STEP3DLab/table-motion-sensor/assets/battery.png

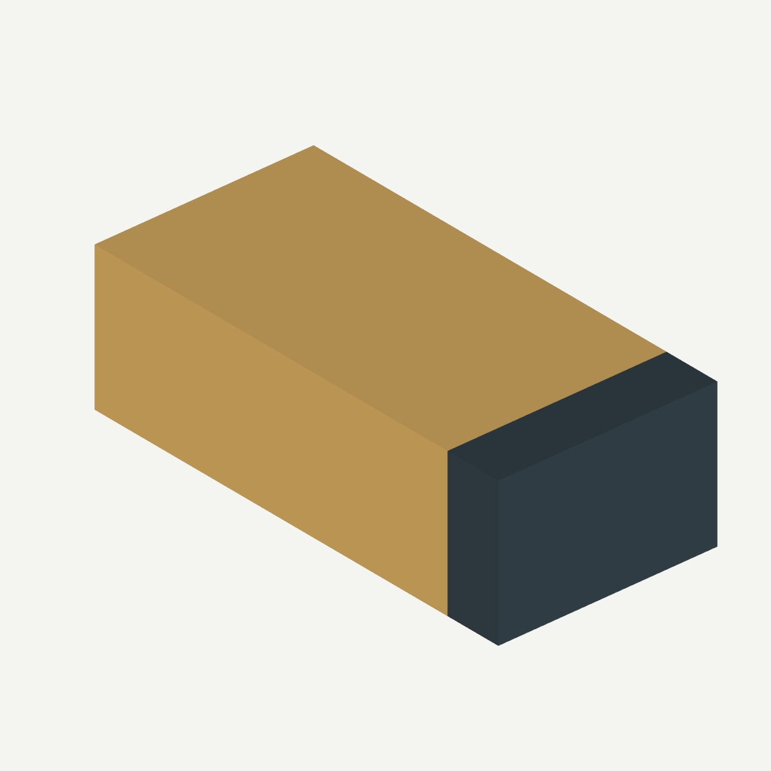
assets/battery.png
