STEP3DLab/table-motion-sensor/assets/case.png

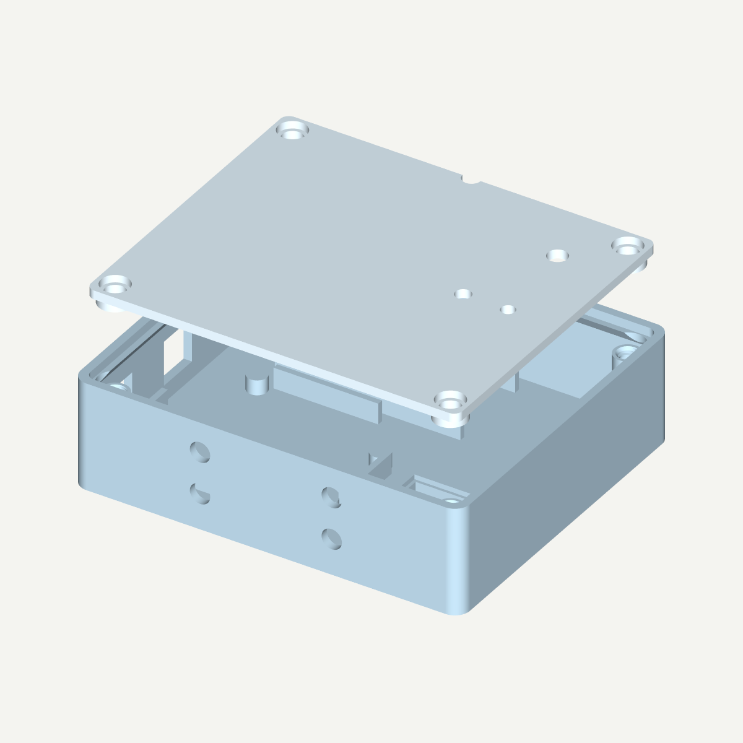
assets/case.png
