STEP3DLab/table-motion-sensor/assets/clamp.png

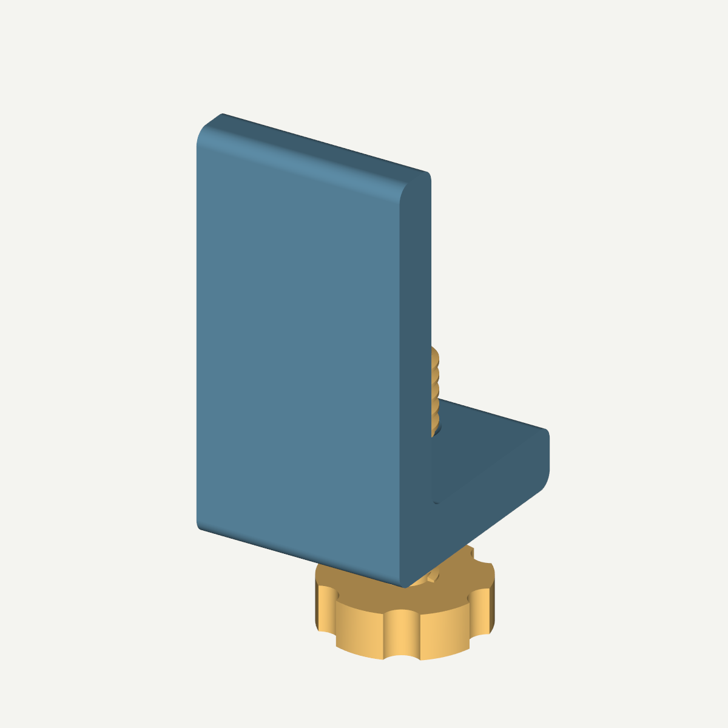
assets/clamp.png
