STEP3DLab/table-motion-sensor/assets/device.png

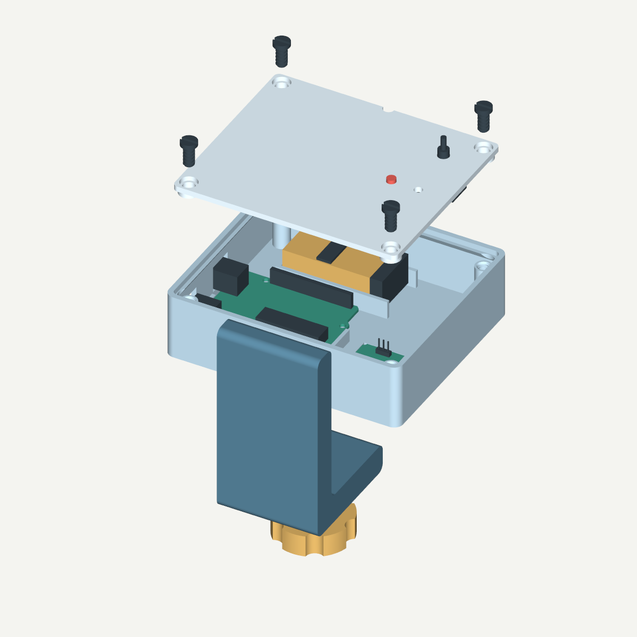
assets/device.png
