STEP3DLab/table-motion-sensor/assets/led.png

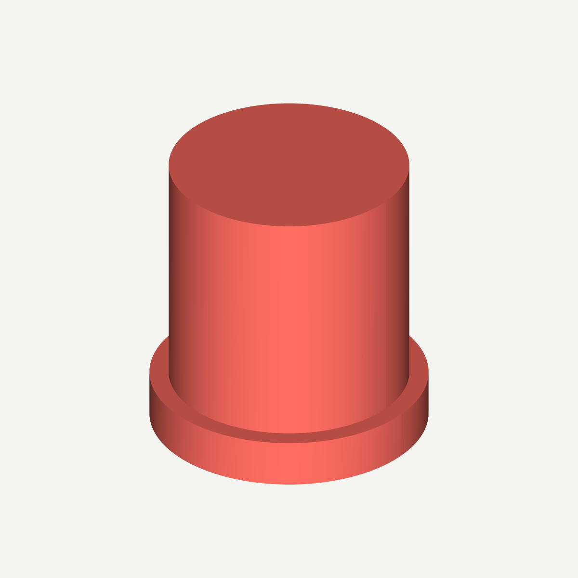
assets/led.png
