STEP3DLab/table-motion-sensor/assets/mount_01_uno.png

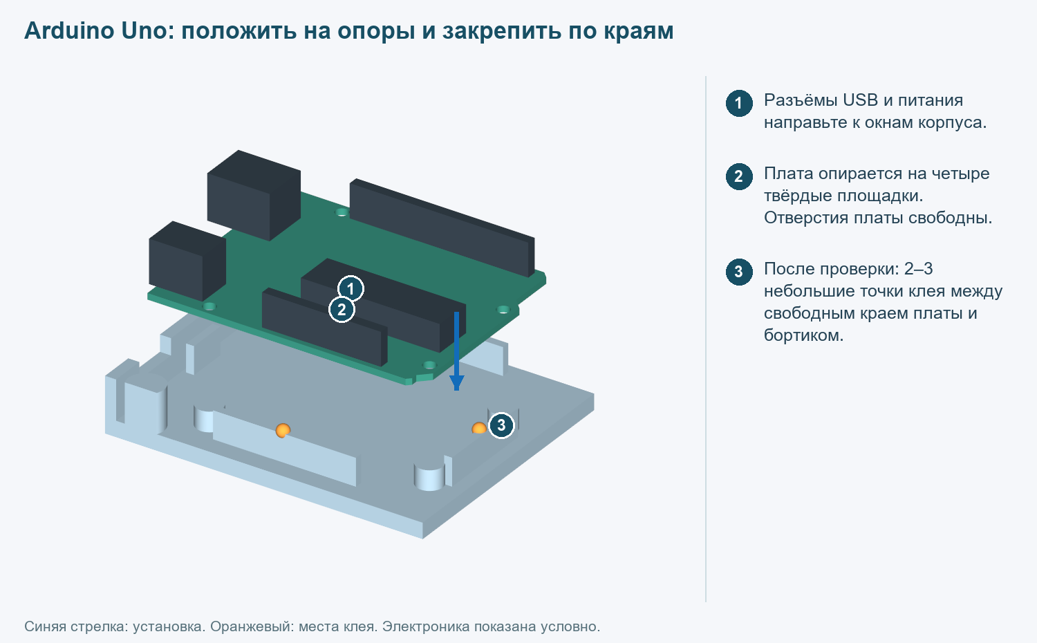
assets/mount_01_uno.png
