STEP3DLab/table-motion-sensor/assets/mount_02_sensor.png

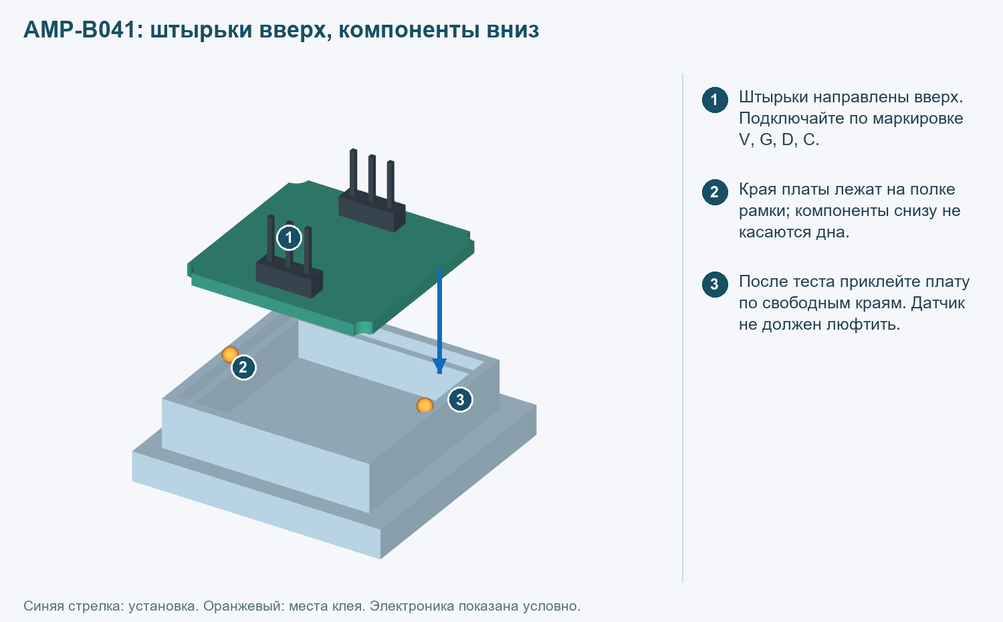
assets/mount_02_sensor.png
