STEP3DLab/table-motion-sensor/assets/mount_03_battery.png

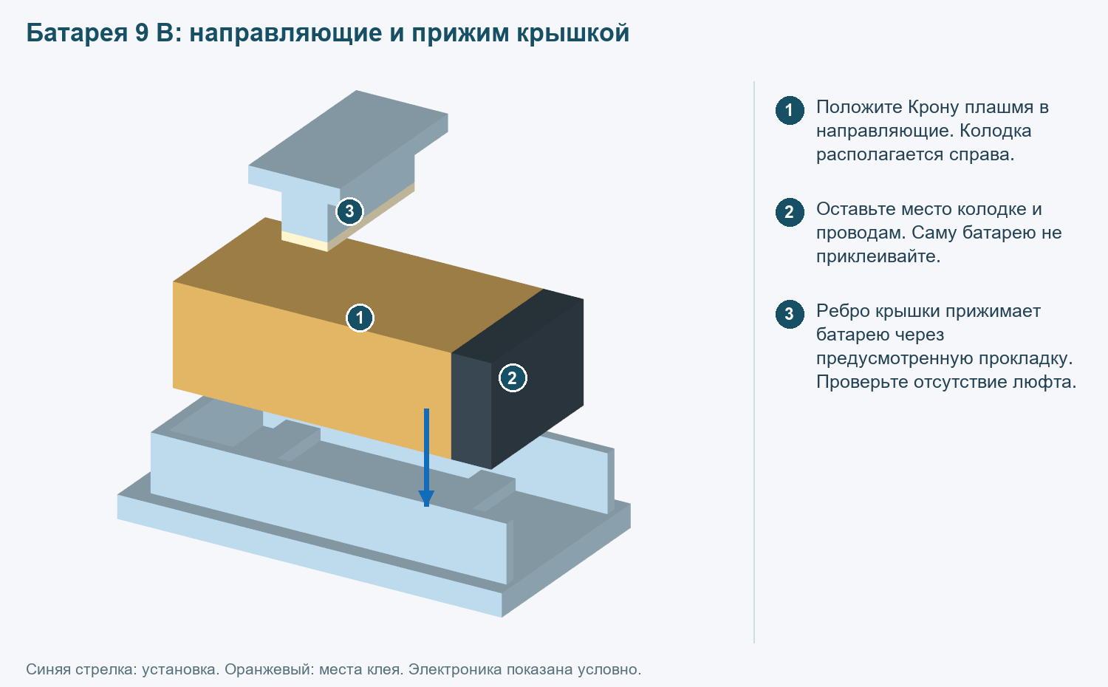
assets/mount_03_battery.png
