STEP3DLab/table-motion-sensor/assets/mount_04_led.png

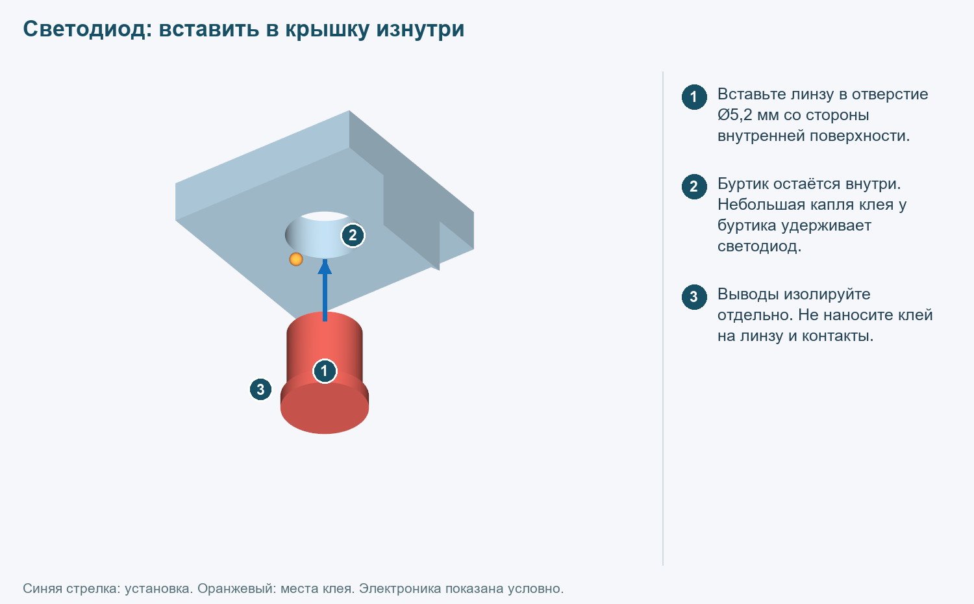
assets/mount_04_led.png
