STEP3DLab/table-motion-sensor/assets/mount_05_piezo.png

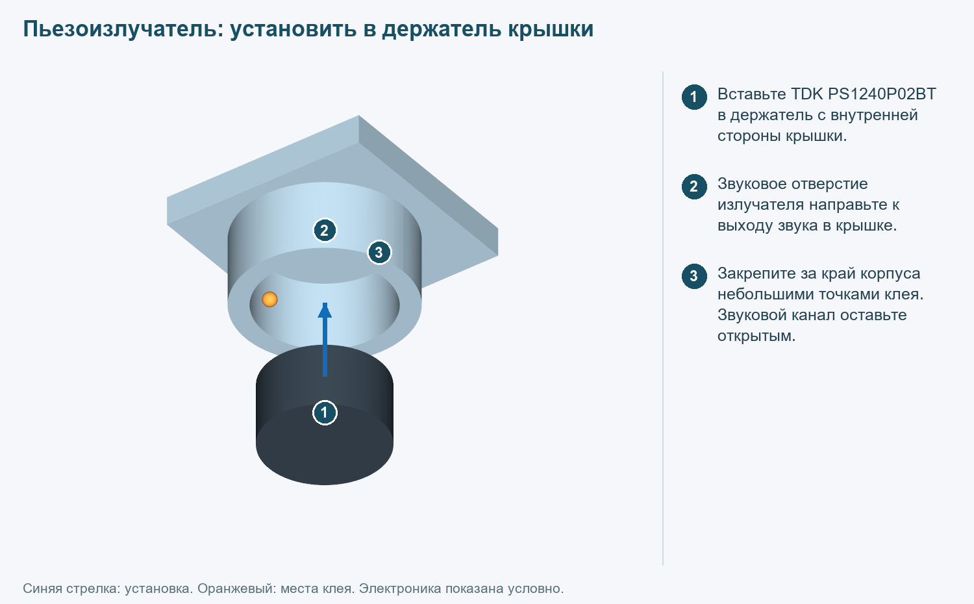
assets/mount_05_piezo.png
