STEP3DLab/table-motion-sensor/assets/mount_06_switch.png

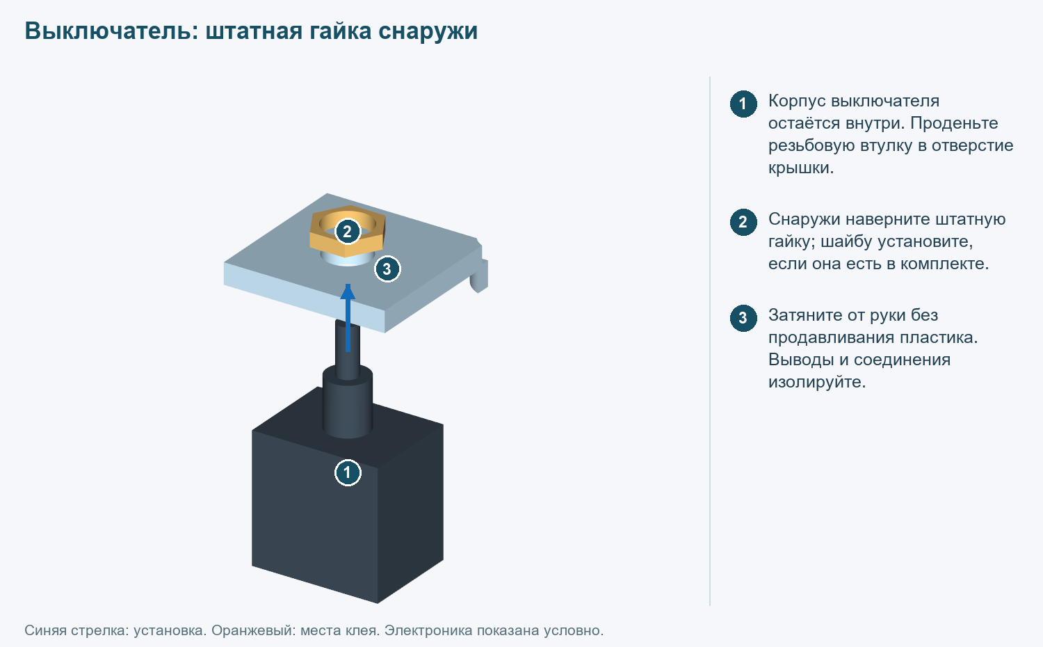
assets/mount_06_switch.png
