STEP3DLab/table-motion-sensor/assets/mount_07_clamp.png

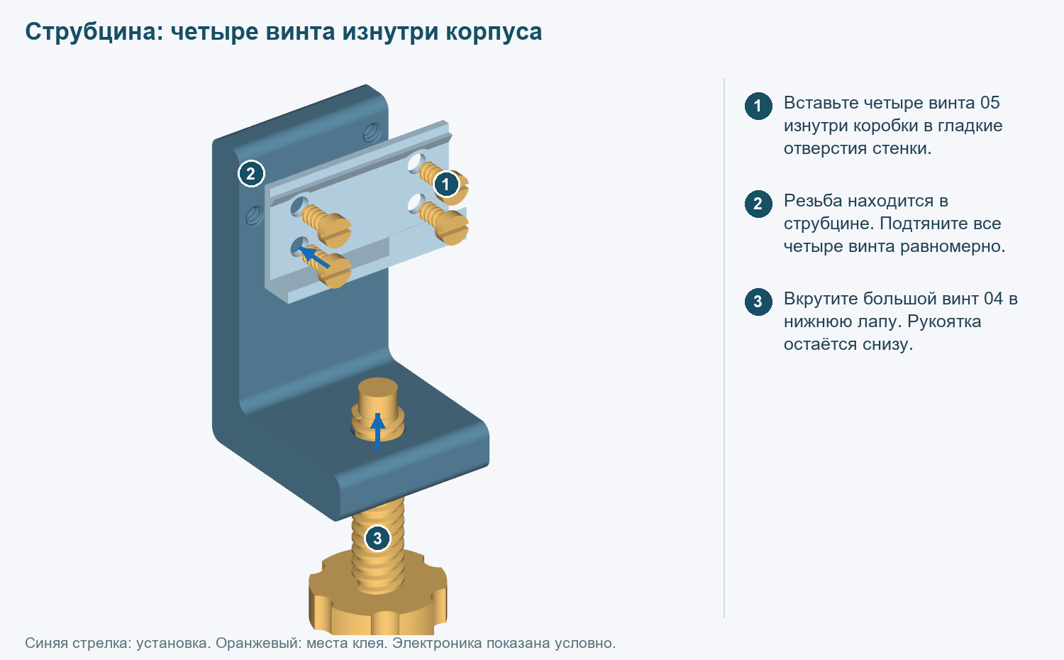
assets/mount_07_clamp.png
