STEP3DLab/table-motion-sensor/assets/mount_08_lid.png

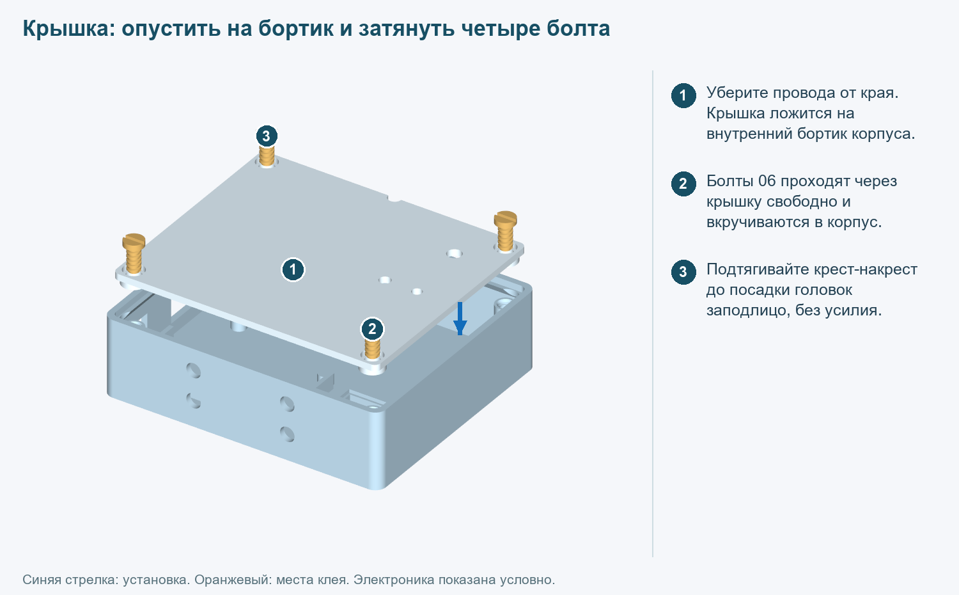
assets/mount_08_lid.png
