STEP3DLab/table-motion-sensor/assets/mount_09_wires.png

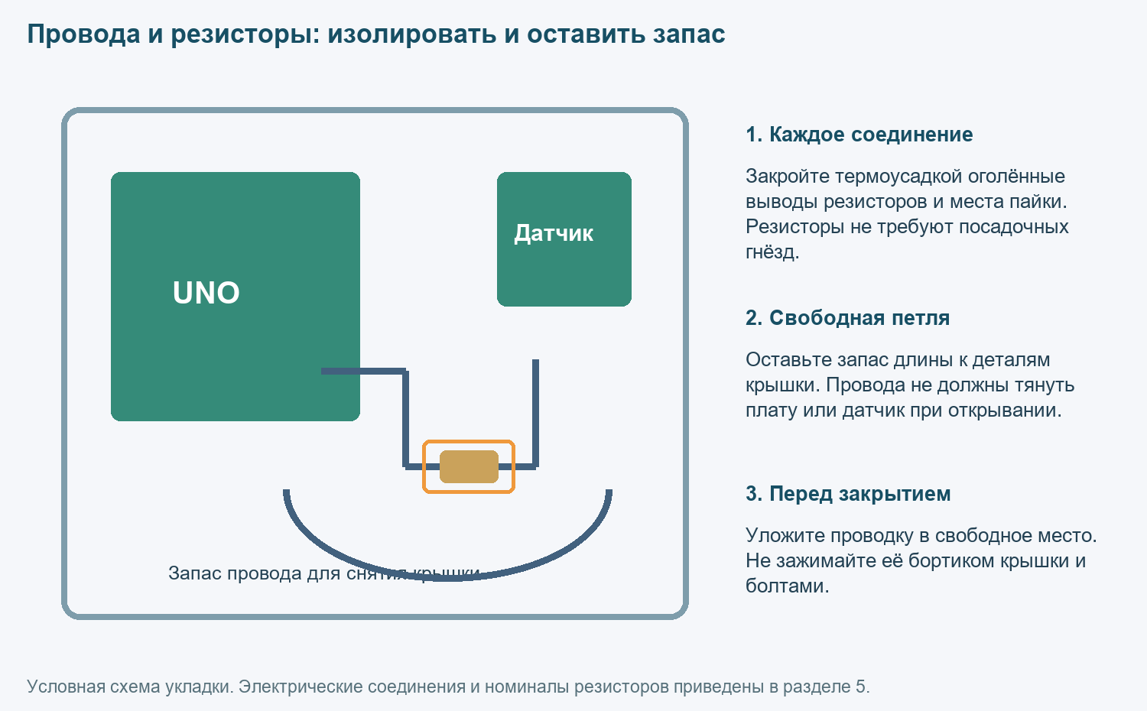
assets/mount_09_wires.png
