STEP3DLab/table-motion-sensor/assets/piezo.png

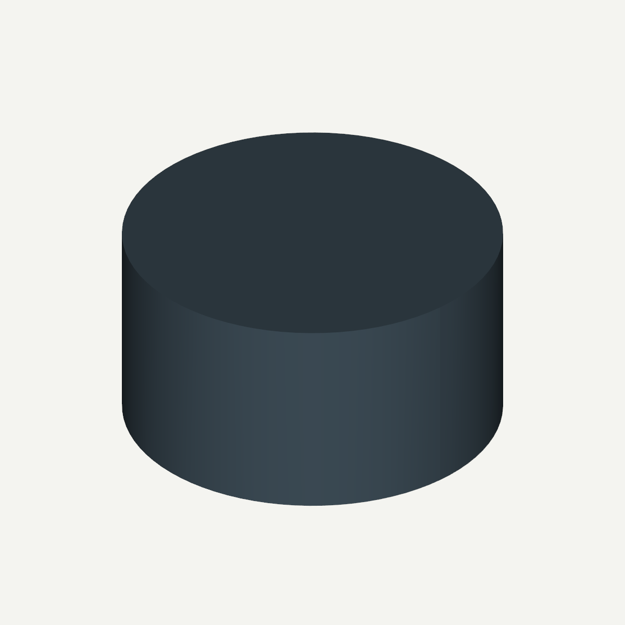
assets/piezo.png
