STEP3DLab/table-motion-sensor/assets/sensor.png

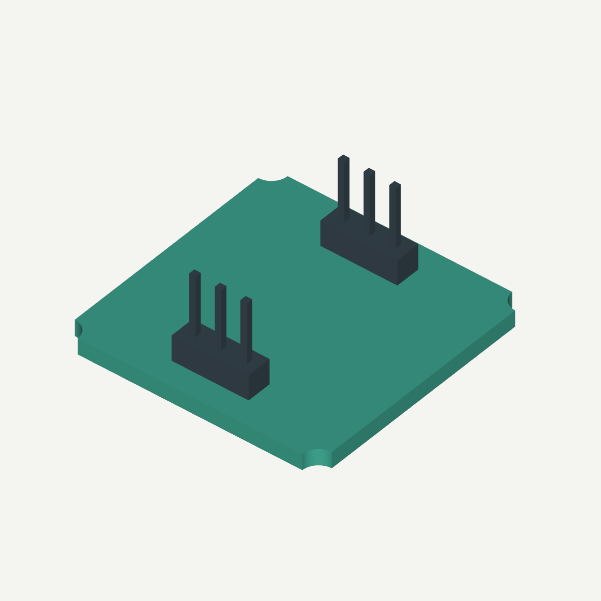
assets/sensor.png
