STEP3DLab/table-motion-sensor/assets/switch.png

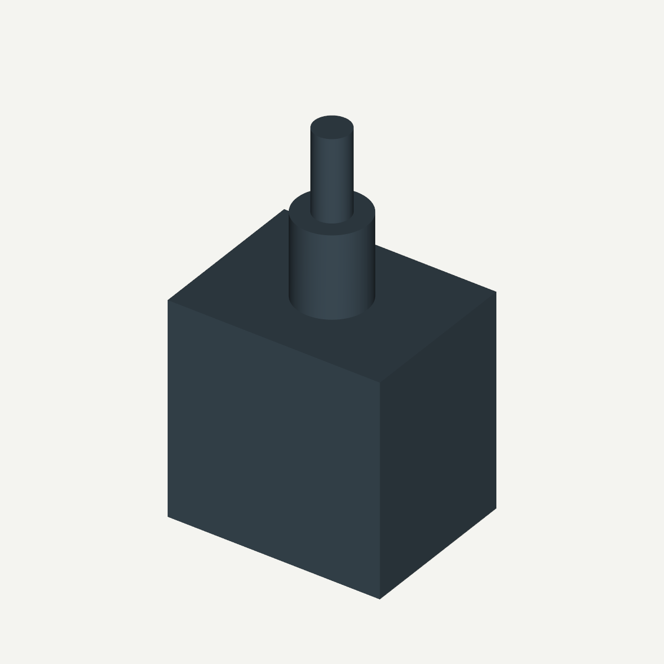
assets/switch.png
