STEP3DLab/table-motion-sensor/assets/table_mount.png

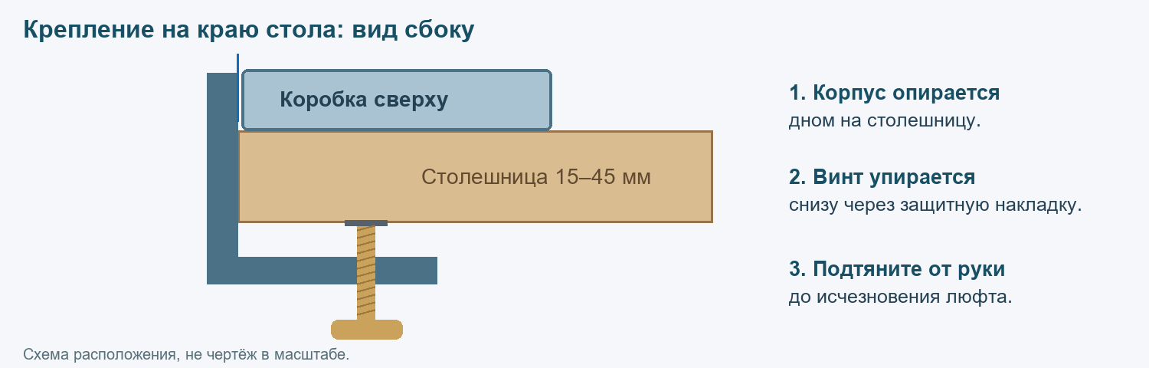
assets/table_mount.png
