STEP3DLab/table-motion-sensor/assets/uno.png

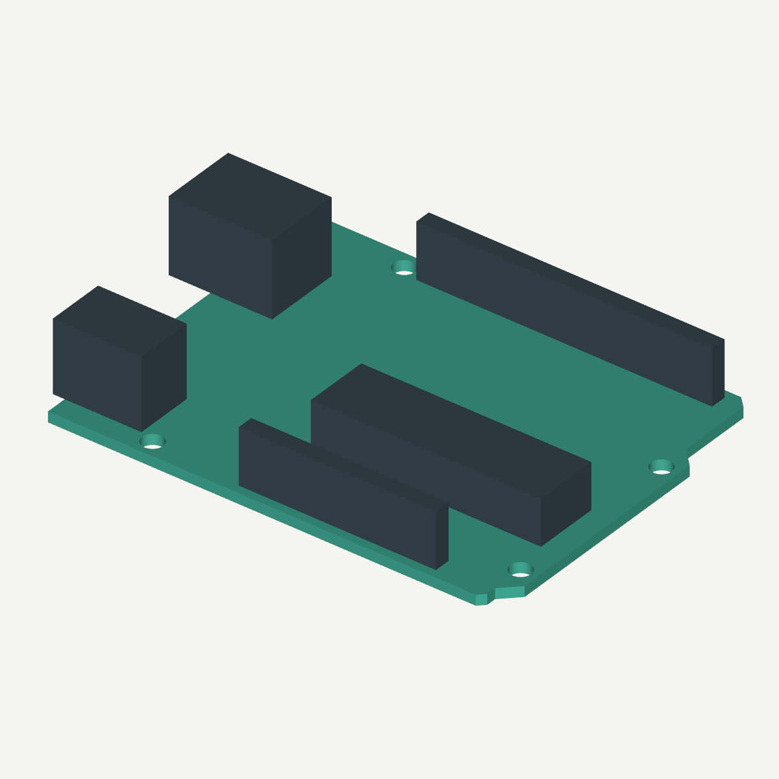
assets/uno.png
