STEP3DLab/table-motion-sensor/v2/assets/case.png

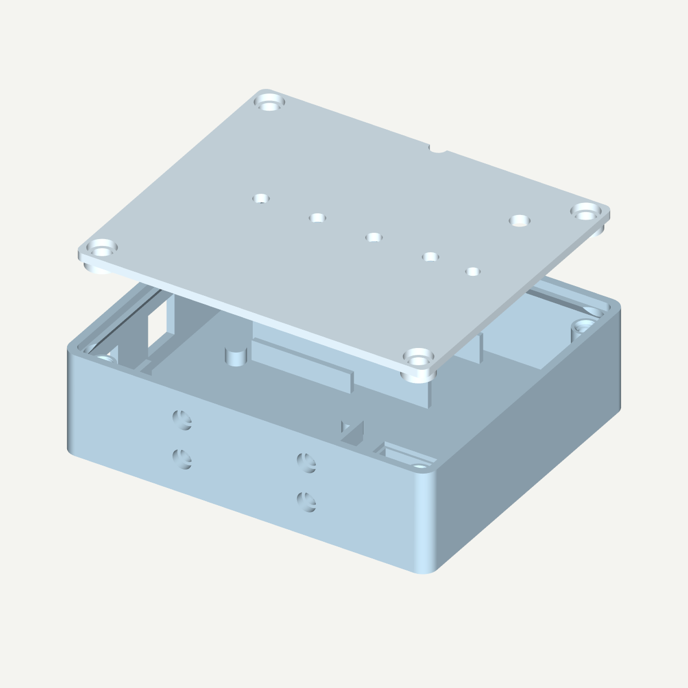
v2/assets/case.png
