STEP3DLab/table-motion-sensor/v2/assets/lid.png

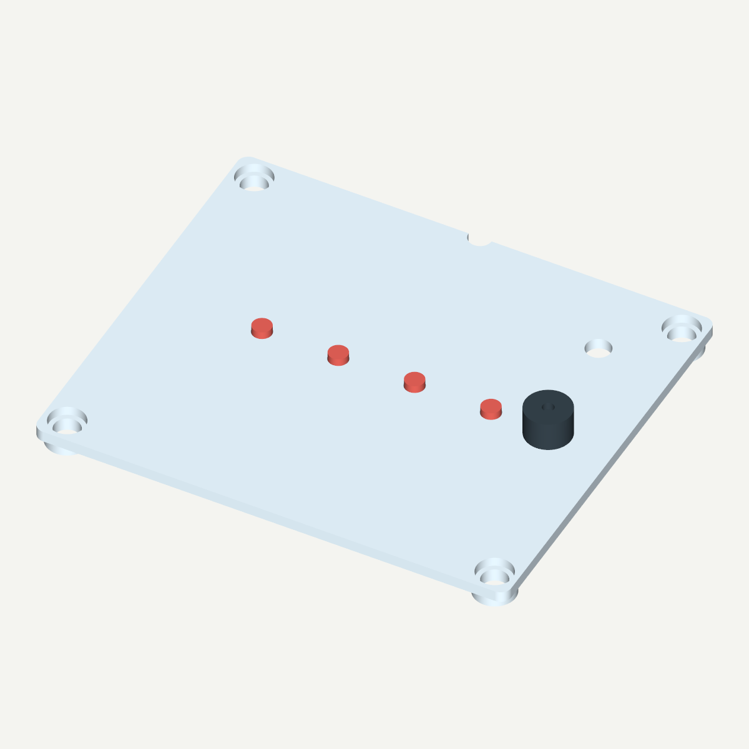
v2/assets/lid.png
