STEP3DLab/table-motion-sensor/downloads/STEP/00_complete_assembly.step

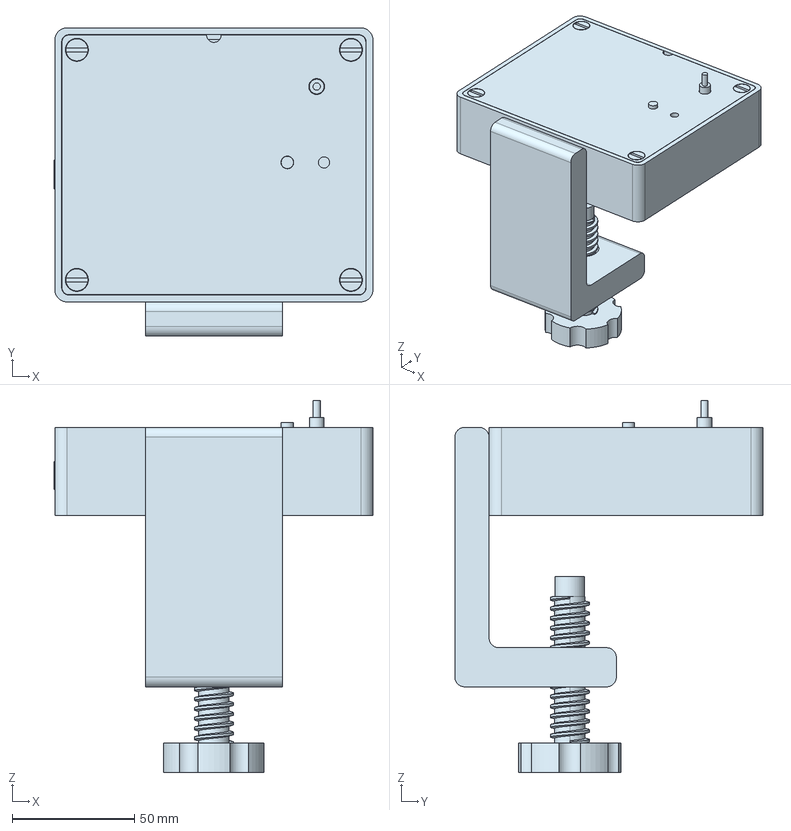
[picture p22: CAD file, 2026-09-21]
downloads/STEP/00_complete_assembly.step
130.3 x 126.0 x 152.0 mm
AMP_B041_0
AMP_B041_1
AMP_B041_2
AMP_B041_3
AMP_B041_4
AMP_B041_5
AMP_B041_6
AMP_B041_7
AMP_B041_8
AMP_B041_9
Existing_0
Existing_1
Existing_2
Existing_3
Existing_4
Existing_5
Existing_6
Existing_7
Existing_8
Existing_9
Existing_10
Existing_11
Existing_12
Existing_13
Existing_14
Existing_15
Existing_16
Existing_17
Existing_18
Existing_19
Existing_20
Existing_21
Existing_22
