STEP3DLab/table-motion-sensor/downloads/STEP/01_box.step

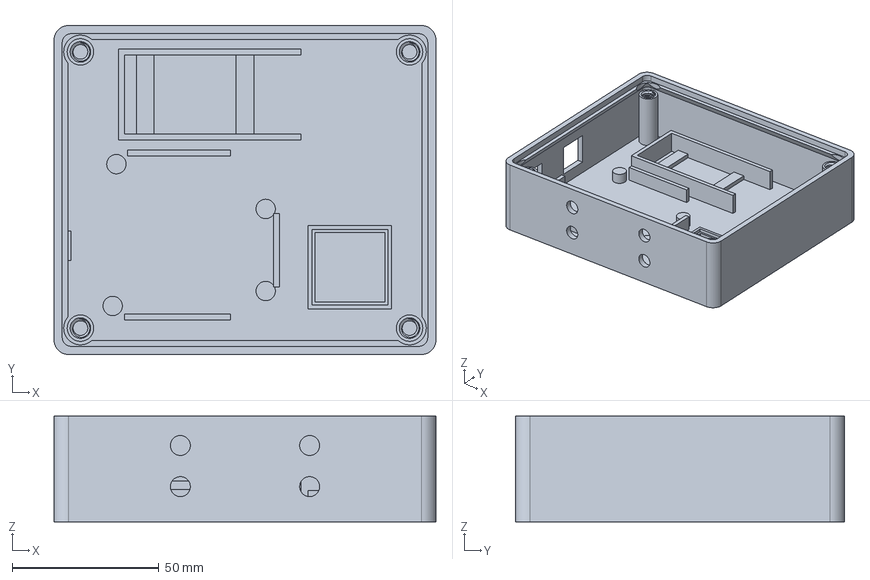
[picture p23: CAD file, 2026-09-21]
downloads/STEP/01_box.step
130.0 x 112.0 x 36.0 mm
