STEP3DLab/table-motion-sensor/downloads/STEP/04_clamp_spindle.step

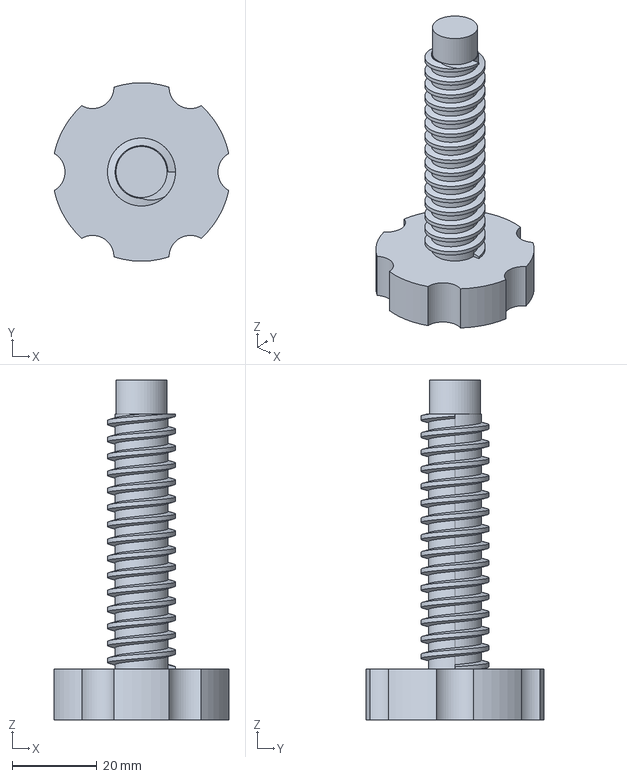
[picture p24: CAD file, 2026-09-21]
downloads/STEP/04_clamp_spindle.step
41.1 x 42.0 x 80.0 mm
