STEP3DLab/table-motion-sensor/downloads/STEP/03_clamp_bracket.step

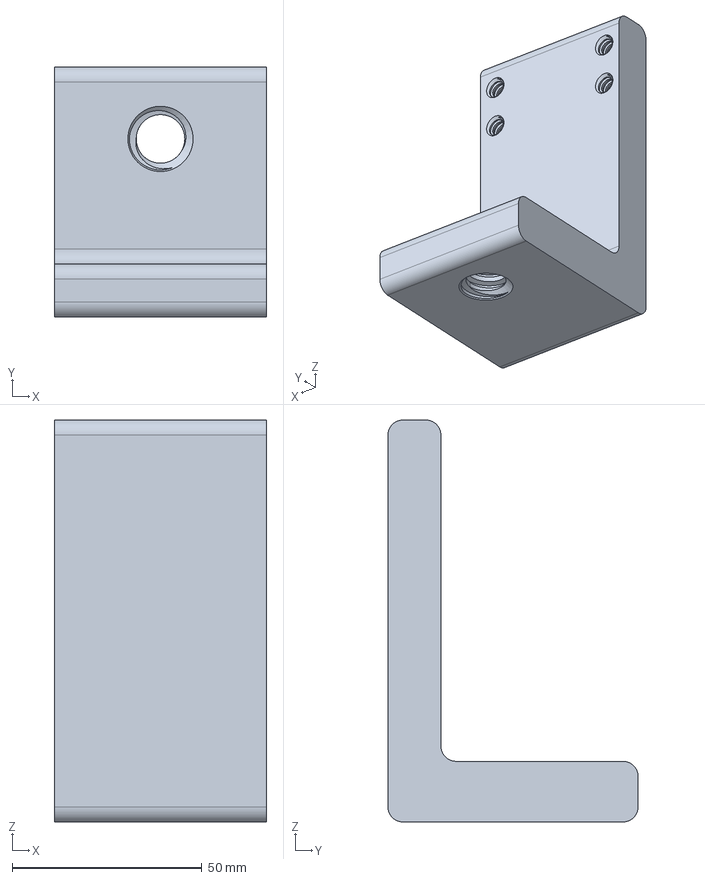
[picture p25: CAD file, 2026-09-21]
downloads/STEP/03_clamp_bracket.step
56.0 x 66.0 x 106.0 mm
