STEP3DLab/table-motion-sensor/downloads/STEP/02_flush_bolted_lid.step

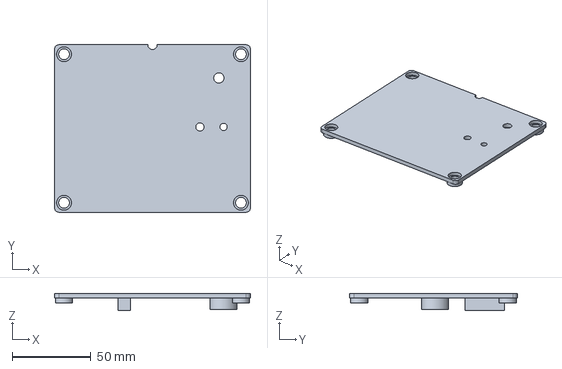
[picture p26: CAD file, 2026-09-21]
downloads/STEP/02_flush_bolted_lid.step
124.1 x 106.1 x 11.0 mm
