STEP3DLab/table-motion-sensor/downloads/STEP/05_bracket_screw_PRINT_4.step

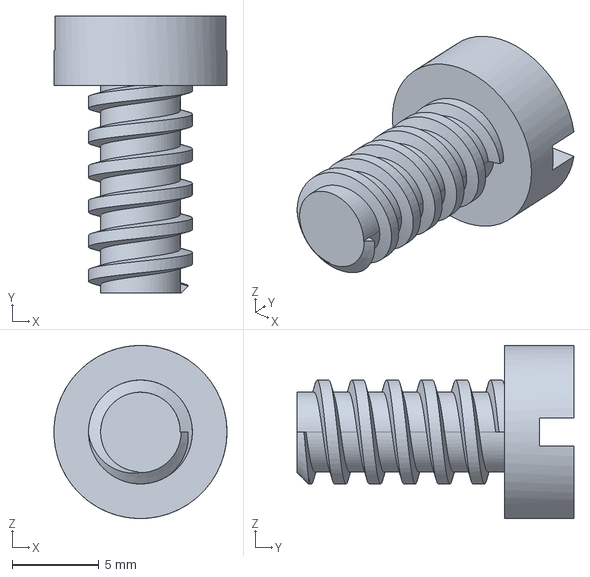
[picture p27: CAD file, 2026-09-21]
downloads/STEP/05_bracket_screw_PRINT_4.step
9.99 x 16.0 x 10.00 mm
