STEP3DLab/table-motion-sensor/downloads/STEP/06_flush_lid_bolt_PRINT_4.step

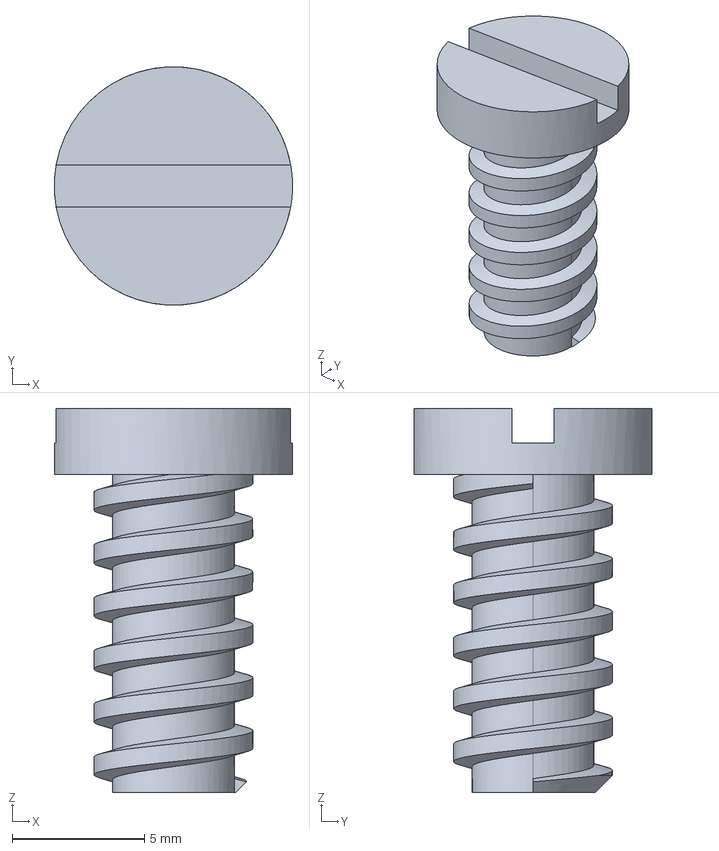
[picture p28: CAD file, 2026-09-21]
downloads/STEP/06_flush_lid_bolt_PRINT_4.step
8.99 x 9.00 x 14.5 mm
