STEP3DLab/table-motion-sensor/(list of files, cad)

Other CAD files:
downloads/STL/01_box.stl
downloads/STL/02_flush_bolted_lid.stl
downloads/STL/03_clamp_bracket.stl
downloads/STL/04_clamp_spindle.stl
downloads/STL/05_bracket_screw_PRINT_4.stl
downloads/STL/06_flush_lid_bolt_PRINT_4.stl
