STEP3DLab/table-motion-sensor/(commit log)

2026-09-21 Publish interactive assembly guide, CAD models and Arduino firmware
    [00_complete_assembly.step, 01_box.step, 01_box.stl, 02_flush_bolted_lid.step, 02_flush_bolted_lid.stl, 03_clamp_bracket.step, 03_clamp_bracket.stl, 04_clamp_spindle.step]
2026-11-09 Add contest edition with external clamp fasteners, stronger indicators and USB scoreboard
